jasshanK/eit_hardware/v0/v0.kicad_pcb

## KiCad design v0/v0.kicad_pcb (2025-01-02)

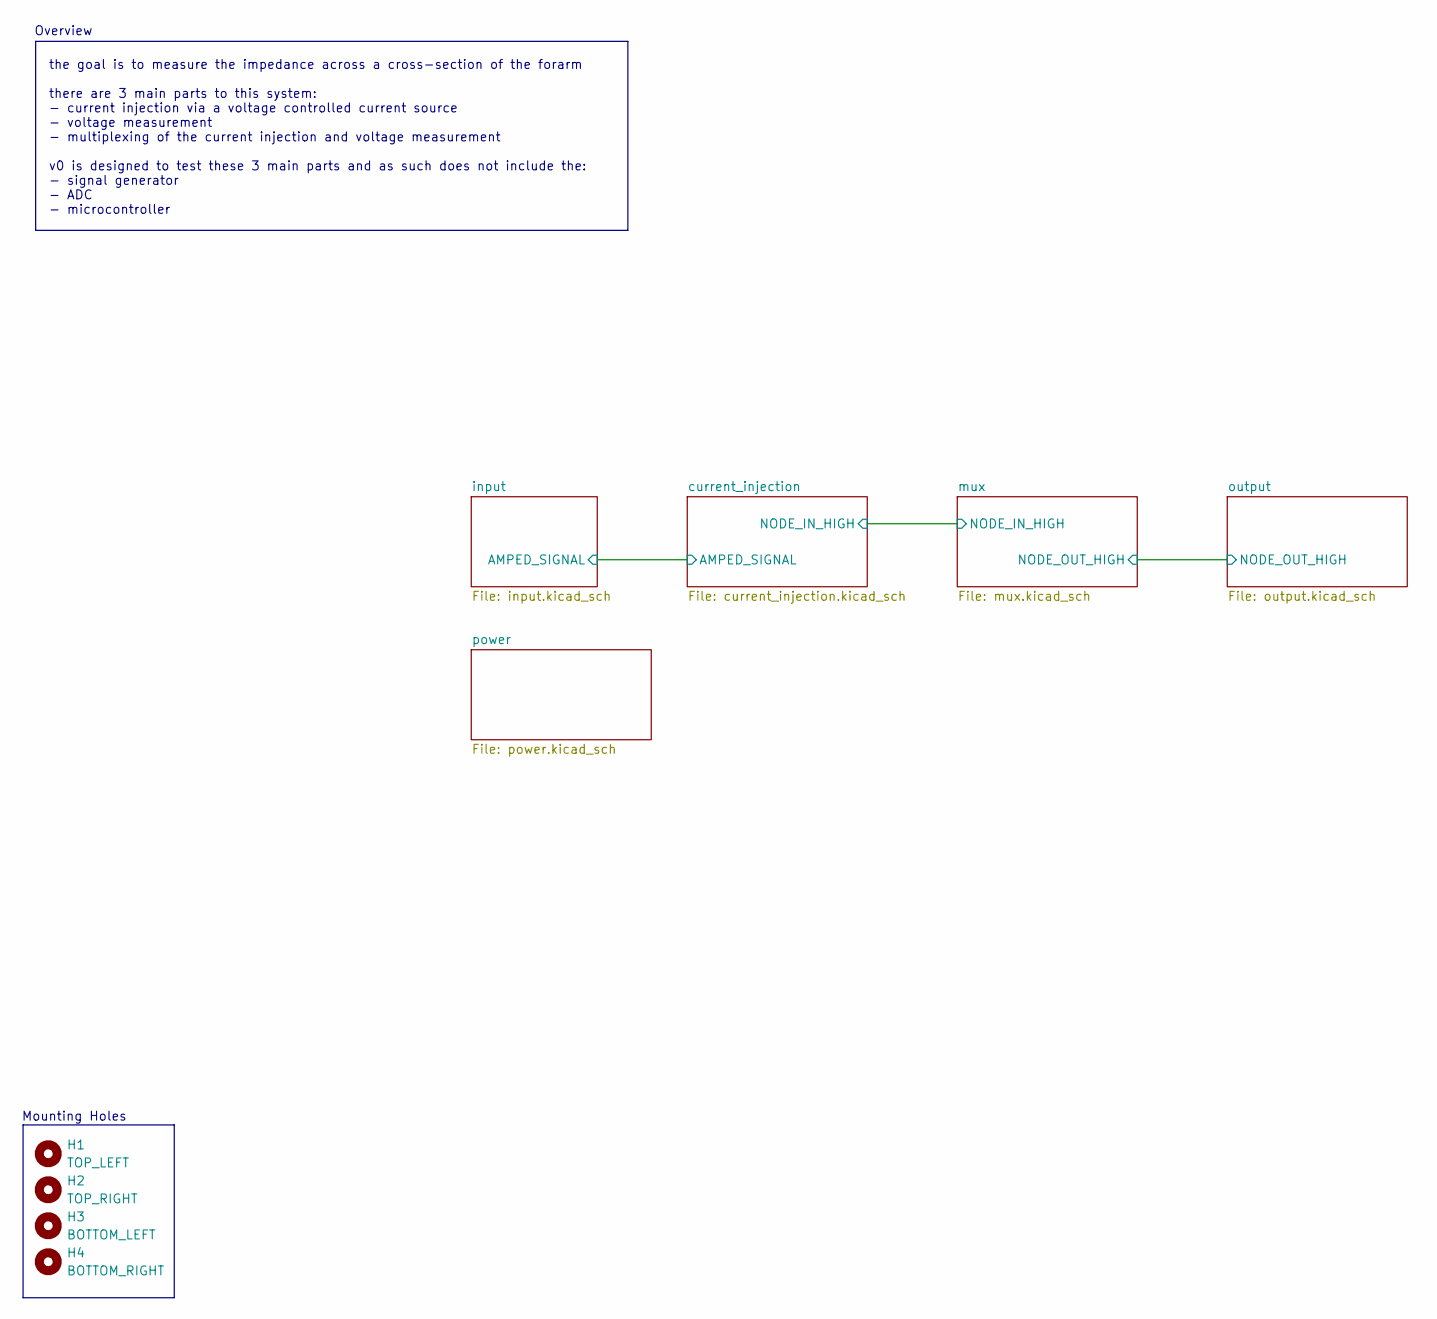
[picture p1: schematic v0.kicad_sch, hand_pose]

Parts:
H1: TOP_LEFT; MountingHole_2.2mm_M2
H2: TOP_RIGHT; MountingHole_2.2mm_M2
H3: BOTTOM_LEFT; MountingHole_2.2mm_M2
H4: BOTTOM_RIGHT; MountingHole_2.2mm_M2

Notes on the sheet:
the goal is to measure the impedance across a cross-section of the forarm there are 3 main parts to this system: - current injection via a voltage controlled current source - voltage measurement - multiplexing of the current injection and voltage measurement v0 is designed to test these 3 main part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
Overview
Mounting Holes

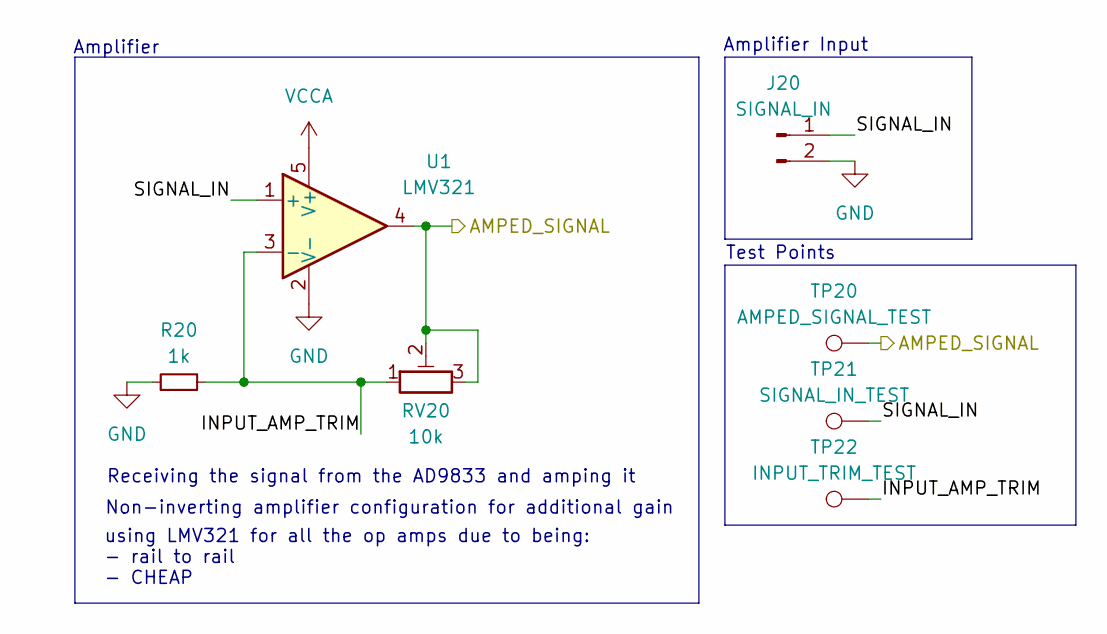
[picture p2: schematic input.kicad_sch]

Parts:
J20: SIGNAL_IN; PinHeader_1x02_P2.54mm_Vertical
R20: 1k; R_0402_1005Metric_Pad0.72x0.64mm_HandSolder
RV20: 10k; Potentiometer_Bourns_3296W_Vertical
TP20: AMPED_SIGNAL_TEST; TestPoint_Loop_D1.80mm_Drill1.0mm_Beaded
TP21: SIGNAL_IN_TEST; TestPoint_Loop_D1.80mm_Drill1.0mm_Beaded
TP22: INPUT_TRIM_TEST; TestPoint_Pad_1.0x1.0mm
U1: LMV321; SOT-23-5

Connections:
/current_injection/AMPED_SIGNAL: RV20.2, RV20.3, TP20.1, U1.4; also elsewhere on the board
/input/INPUT_AMP_TRIM: R20.2, RV20.1, TP22.1, U1.3 (-)
/input/SIGNAL_IN: J20.1, TP21.1, U1.1 (+)
GND: J20.2, R20.1, U1.2 (V-); also elsewhere on the board
VCCA: U1.5 (V+); also elsewhere on the board

Notes on the sheet:
Receiving the signal from the AD9833 and amping it
using LMV321 for all the op amps due to being: - rail to rail - CHEAP
Amplifier Input
Test Points
Non-inverting amplifier configuration for additional gain
Amplifier

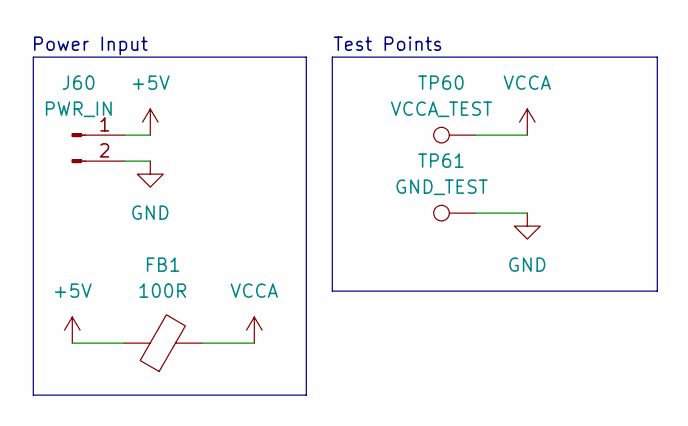
[picture p3: schematic power.kicad_sch]

Parts:
FB1: 100R; L_0805_2012Metric_Pad1.05x1.20mm_HandSolder
J60: PWR_IN; PinHeader_1x02_P2.54mm_Vertical
TP60: VCCA_TEST; TestPoint_Loop_D1.80mm_Drill1.0mm_Beaded
TP61: GND_TEST; TestPoint_Loop_D1.80mm_Drill1.0mm_Beaded

Connections:
+5V: FB1.1, J60.1
GND: J60.2, TP61.1; also elsewhere on the board
VCCA: FB1.2, TP60.1; also elsewhere on the board

Notes on the sheet:
Test Points
Power Input

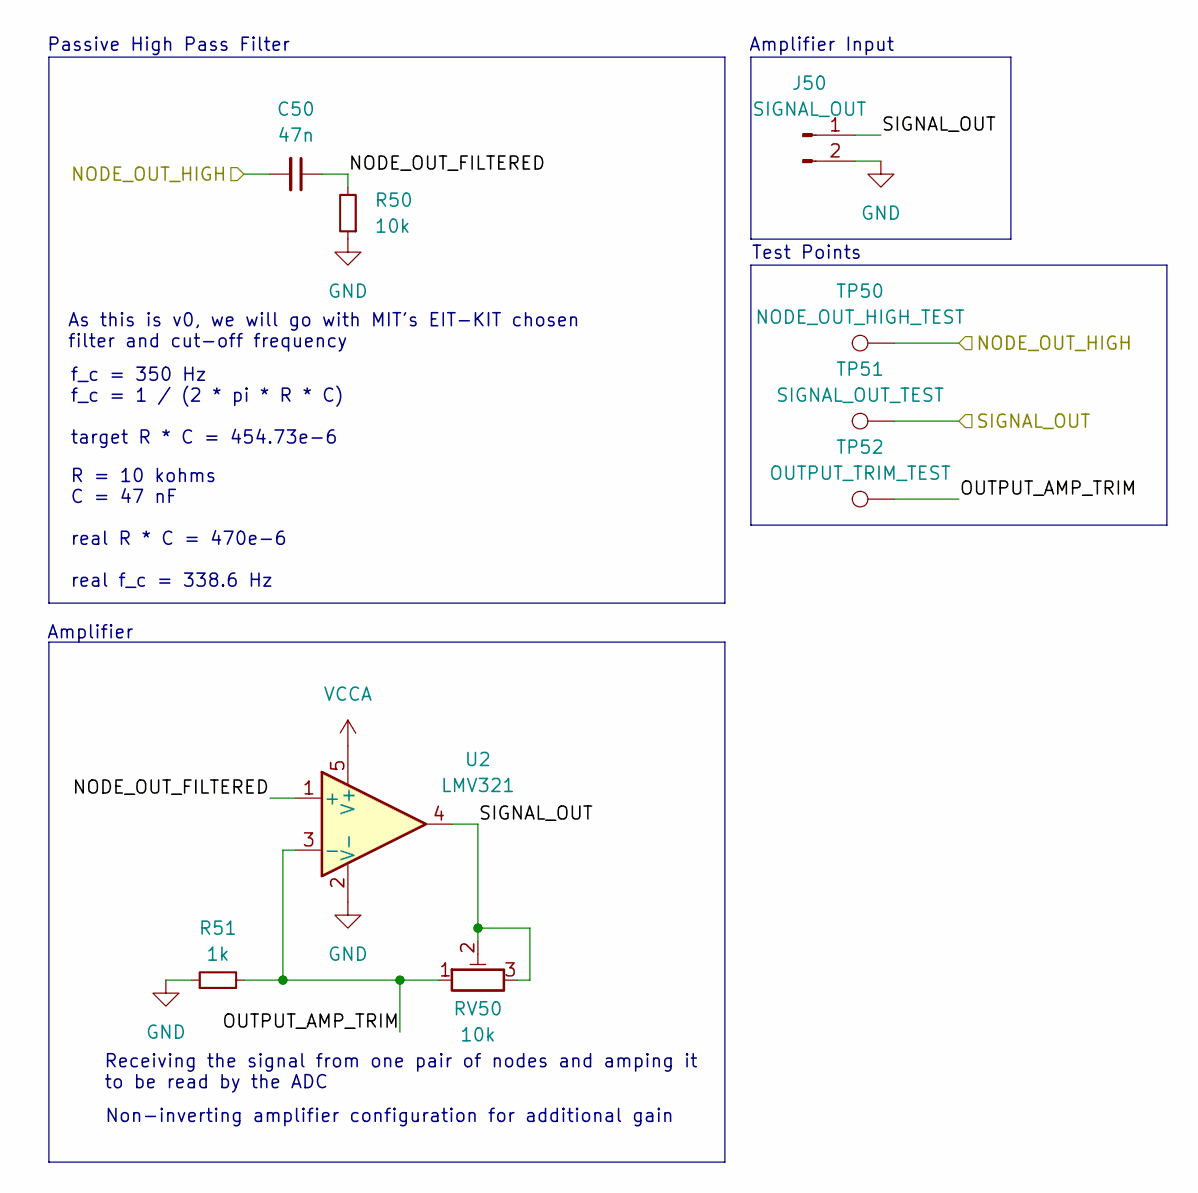
[picture p4: schematic output.kicad_sch]

Parts:
C50: 47n; C_0402_1005Metric_Pad0.74x0.62mm_HandSolder
J50: SIGNAL_OUT; PinHeader_1x02_P2.54mm_Vertical
R50: 10k; R_0402_1005Metric_Pad0.72x0.64mm_HandSolder
R51: 1k; R_0402_1005Metric_Pad0.72x0.64mm_HandSolder
RV50: 10k; Potentiometer_Bourns_3296W_Vertical
TP50: NODE_OUT_HIGH_TEST; TestPoint_Loop_D1.80mm_Drill1.0mm_Beaded
TP51: SIGNAL_OUT_TEST; TestPoint_Loop_D1.80mm_Drill1.0mm_Beaded
TP52: OUTPUT_TRIM_TEST; TestPoint_Pad_1.0x1.0mm
U2: LMV321; SOT-23-5

Connections:
/mux/NODE_OUT_HIGH: C50.2, TP50.1; also elsewhere on the board
/output/NODE_OUT_FILTERED: C50.1, R50.2, U2.1 (+)
/output/OUTPUT_AMP_TRIM: R51.2, RV50.1, TP52.1, U2.3 (-)
/output/SIGNAL_OUT: J50.1, RV50.2, RV50.3, TP51.1, U2.4
GND: J50.2, R50.1, R51.1, U2.2 (V-); also elsewhere on the board
VCCA: U2.5 (V+); also elsewhere on the board

Notes on the sheet:
As this is v0, we will go with MIT's EIT-KIT chosen filter and cut-off frequency
f_c = 350 Hz f_c = 1 / (2 * pi * R * C) target R * C = 454.73e-6
Non-inverting amplifier configuration for additional gain
Amplifier
Passive High Pass Filter
Receiving the signal from one pair of nodes and amping it to be read by the ADC
Amplifier Input
Test Points
R = 10 kohms C = 47 nF real R * C = 470e-6 real f_c = 338.6 Hz

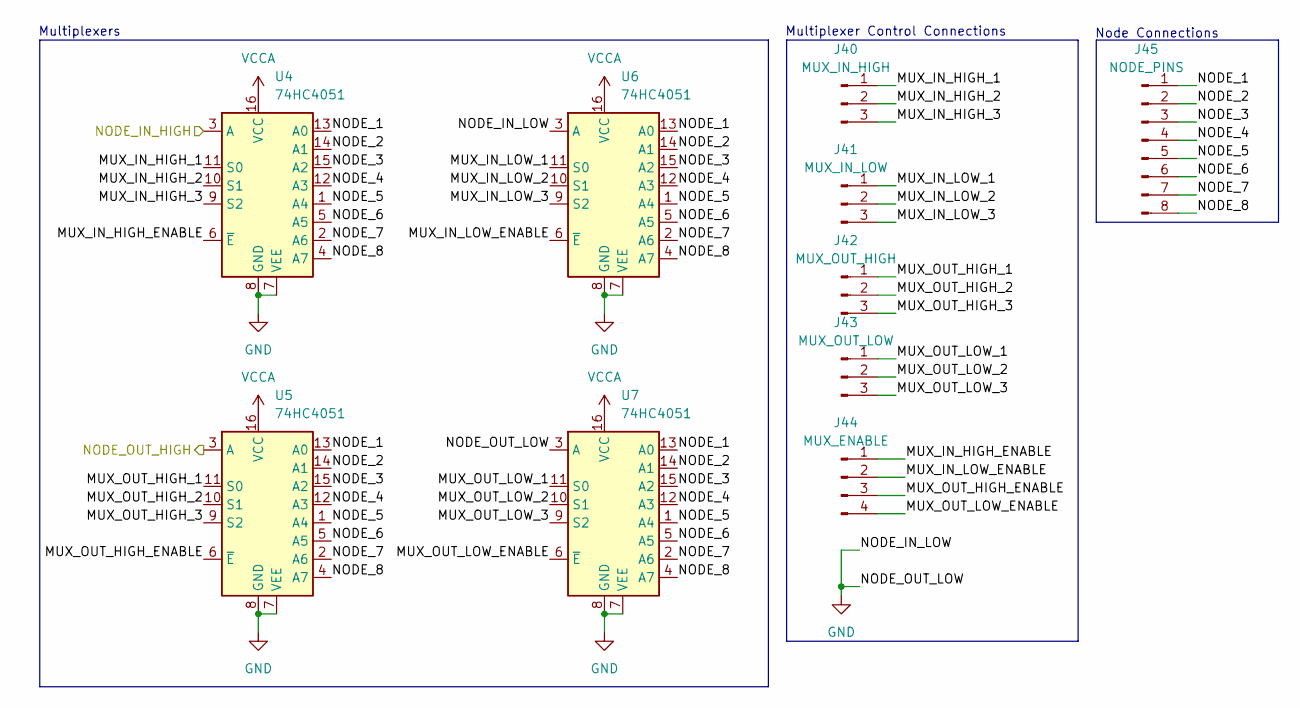
[picture p5: schematic mux.kicad_sch]

Parts:
J40: MUX_IN_HIGH; PinHeader_1x03_P2.54mm_Vertical
J41: MUX_IN_LOW; PinHeader_1x03_P2.54mm_Vertical
J42: MUX_OUT_HIGH; PinHeader_1x03_P2.54mm_Vertical
J43: MUX_OUT_LOW; PinHeader_1x03_P2.54mm_Vertical
J44: MUX_ENABLE; PinHeader_1x04_P2.54mm_Vertical
J45: NODE_PINS; PinHeader_2x04_P2.54mm_Vertical
U4, U5, U6, U7: 74HC4051; SOIC-16_3.9x9.9mm_P1.27mm

Connections:
/current_injection/NODE_IN_HIGH: U4.3 (A); also elsewhere on the board
/mux/MUX_IN_HIGH_1: J40.1, U4.11 (S0)
/mux/MUX_IN_HIGH_2: J40.2, U4.10 (S1)
/mux/MUX_IN_HIGH_3: J40.3, U4.9 (S2)
/mux/MUX_IN_HIGH_ENABLE: J44.1, U4.6 (~E)
/mux/MUX_IN_LOW_1: J41.1, U6.11 (S0)
/mux/MUX_IN_LOW_2: J41.2, U6.10 (S1)
/mux/MUX_IN_LOW_3: J41.3, U6.9 (S2)
/mux/MUX_IN_LOW_ENABLE: J44.2, U6.6 (~E)
/mux/MUX_OUT_HIGH_1: J42.1, U5.11 (S0)
/mux/MUX_OUT_HIGH_2: J42.2, U5.10 (S1)
/mux/MUX_OUT_HIGH_3: J42.3, U5.9 (S2)
/mux/MUX_OUT_HIGH_ENABLE: J44.3, U5.6 (~E)
/mux/MUX_OUT_LOW_1: J43.1, U7.11 (S0)
/mux/MUX_OUT_LOW_2: J43.2, U7.10 (S1)
/mux/MUX_OUT_LOW_3: J43.3, U7.9 (S2)
/mux/MUX_OUT_LOW_ENABLE: J44.4, U7.6 (~E)
/mux/NODE_1: J45.1, U4.13 (A0), U5.13 (A0), U6.13 (A0), U7.13 (A0)
/mux/NODE_2: J45.2, U4.14 (A1), U5.14 (A1), U6.14 (A1), U7.14 (A1)
/mux/NODE_3: J45.3, U4.15 (A2), U5.15 (A2), U6.15 (A2), U7.15 (A2)
/mux/NODE_4: J45.4, U4.12 (A3), U5.12 (A3), U6.12 (A3), U7.12 (A3)
/mux/NODE_5: J45.5, U4.1 (A4), U5.1 (A4), U6.1 (A4), U7.1 (A4)
/mux/NODE_6: J45.6, U4.5 (A5), U5.5 (A5), U6.5 (A5), U7.5 (A5)
/mux/NODE_7: J45.7, U4.2 (A6), U5.2 (A6), U6.2 (A6), U7.2 (A6)
/mux/NODE_8: J45.8, U4.4 (A7), U5.4 (A7), U6.4 (A7), U7.4 (A7)
/mux/NODE_OUT_HIGH: U5.3 (A); also elsewhere on the board
GND: U4.7 (VEE), U4.8 (GND), U5.7 (VEE), U5.8 (GND), U6.3 (A), U6.7 (VEE), U6.8 (GND), U7.3 (A), U7.7 (VEE), U7.8 (GND); also elsewhere on the board
VCCA: U4.16 (VCC), U5.16 (VCC), U6.16 (VCC), U7.16 (VCC); also elsewhere on the board

Notes on the sheet:
Multiplexer Control Connections
Multiplexers
Node Connections

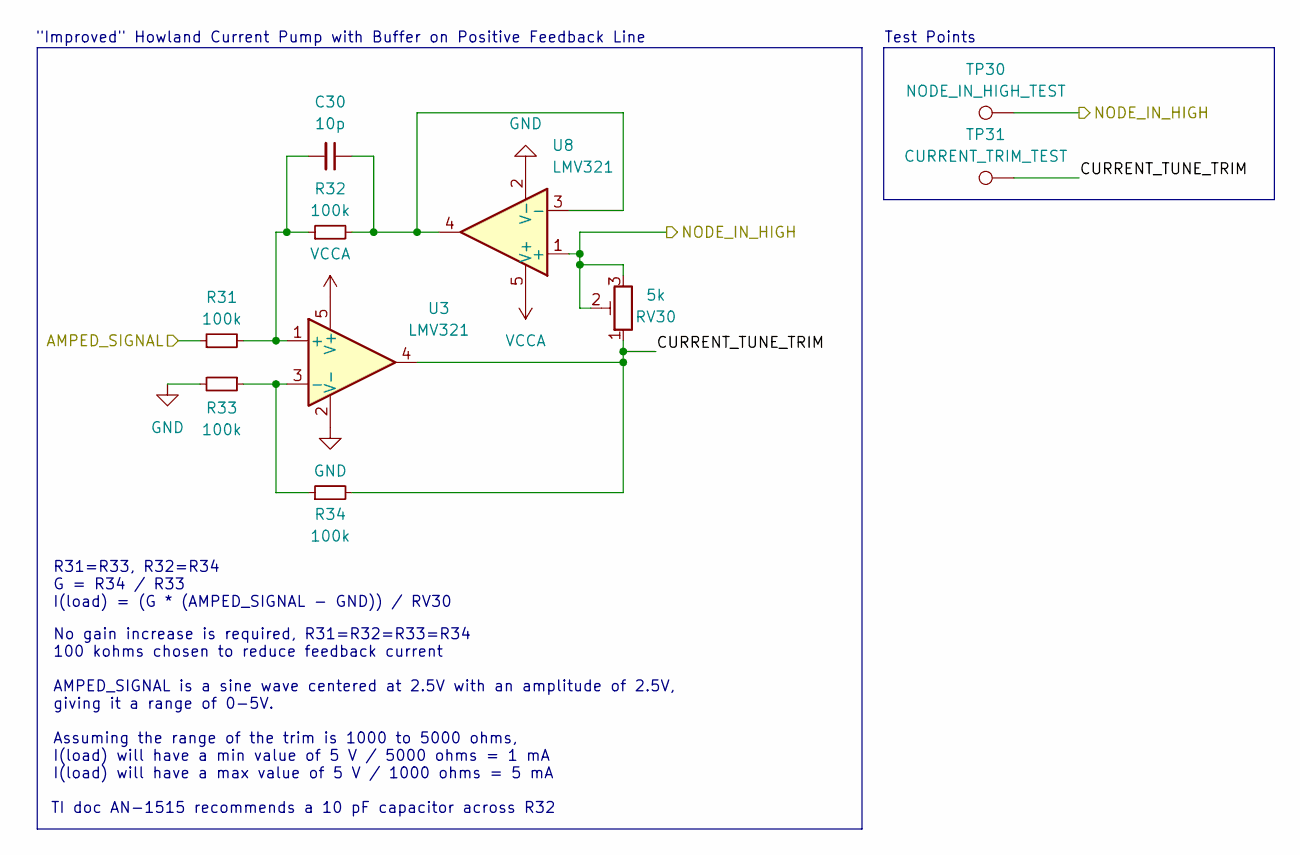
[picture p6: schematic current_injection.kicad_sch]

Parts:
C30: 10p; C_0402_1005Metric_Pad0.74x0.62mm_HandSolder
R31, R32, R33, R34: 100k; R_0805_2012Metric_Pad1.20x1.40mm_HandSolder
RV30: 5k; Potentiometer_Bourns_3296W_Vertical
TP30: NODE_IN_HIGH_TEST; TestPoint_Loop_D1.80mm_Drill1.0mm_Beaded
TP31: CURRENT_TRIM_TEST; TestPoint_Pad_1.0x1.0mm
U3, U8: LMV321; SOT-23-5

Connections:
/current_injection/AMPED_SIGNAL: R31.1; also elsewhere on the board
/current_injection/CURRENT_TUNE_TRIM: R34.2, RV30.1, TP31.1, U3.4
/current_injection/NODE_IN_HIGH: RV30.2, RV30.3, TP30.1, U8.1 (+); also elsewhere on the board
GND: R33.2, U3.2 (V-), U8.2 (V-); also elsewhere on the board
unnamed: C30.2, R31.2, R32.1, U3.1 (+)
unnamed: R33.1, R34.1, U3.3 (-)
unnamed: C30.1, R32.2, U8.3 (-), U8.4
VCCA: U3.5 (V+), U8.5 (V+); also elsewhere on the board

Notes on the sheet:
Test Points
Assuming the range of the trim is 1000 to 5000 ohms, I(load) will have a min value of 5 V / 5000 ohms = 1 mA I(load) will have a max value of 5 V / 1000 ohms = 5 mA
"Improved" Howland Current Pump with Buffer on Positive Feedback Line
TI doc AN-1515 recommends a 10 pF capacitor across R32
No gain increase is required, R31=R32=R33=R34 100 kohms chosen to reduce feedback current
R31=R33, R32=R34 G = R34 / R33 I(load) = (G * (AMPED_SIGNAL - GND)) / RV30
AMPED_SIGNAL is a sine wave centered at 2.5V with an amplitude of 2.5V, giving it a range of 0-5V.

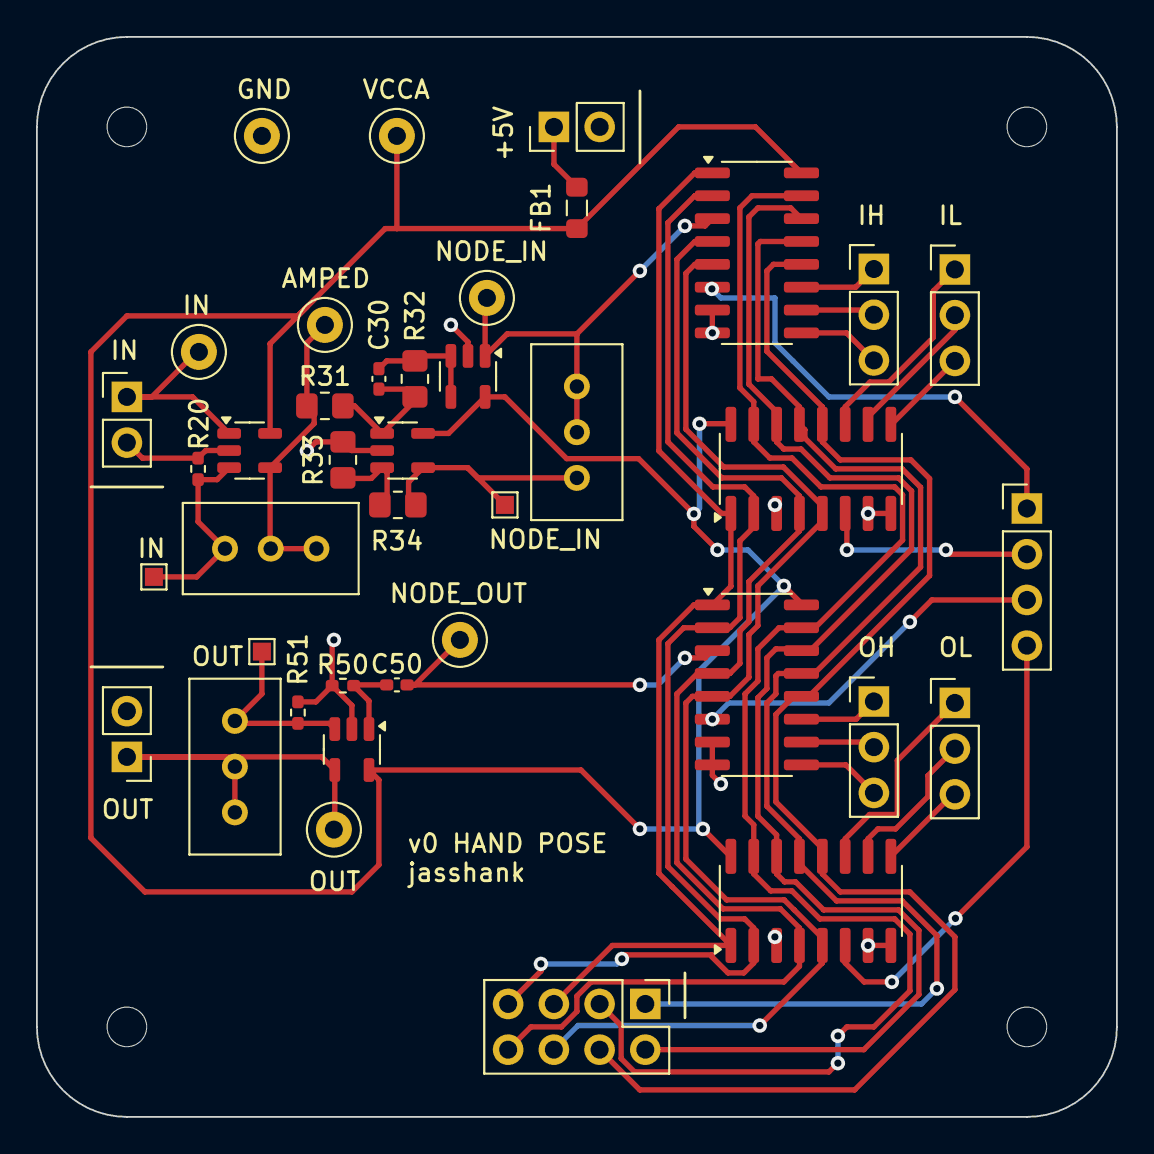
[picture p7: board v0.kicad_pcb from above]

Board: 2 copper layers, 60.0 x 60.0 mm, 44 parts (0 on the bottom side), 39 nets.
