jasshanK/eit_hardware/(commit log)

2025-01-02 finally putting it on git
    [analog_circuit.kicad_sch, current_injection.kicad_sch, input.kicad_sch, input_output.kicad_sch, mux.kicad_sch, output.kicad_sch, power.kicad_sch, v0.csv]
2025-02-14 esp32-based integration test of the board
    [v0.sync-conflict-20250131-120216-HTISFCI.kicad_sch]
